sujaygouda123/foc-control/bom/foc-control.csv

Reference | Qty | Value | Exclude from BOM | Footprint | Datasheet | MPN
C1,C2,C3,C4,C6,C7,C8,C9,C10,C12,C16,C40,C47 | 13 | 100 nF 16V X7R |  | Capacitor_SMD:C_0603_1608Metric
C5,C13,C31,C32,C35,C38,C39 | 7 | 1 µF 16V X7R |  | Capacitor_SMD:C_0603_1608Metric
C11 | 1 | 10 µF 16V X5R |  | Capacitor_SMD:C_0603_1608Metric
C14,C15 | 2 | 27 pF 50V C0G |  | Capacitor_SMD:C_0603_1608Metric
C17,C18,C24,C25,C41,C42,C43 | 7 | 2.2 µF 100V X7R |  | Capacitor_SMD:C_1210_3225Metric
C19,C26 | 2 | 2.2 nF 50V X7R |  | Capacitor_SMD:C_0603_1608Metric
C20,C27 | 2 | 3.3 nF 50V X7R |  | Capacitor_SMD:C_0603_1608Metric
C21 | 1 | 56 pF 50V C0G |  | Capacitor_SMD:C_0603_1608Metric
C22,C23 | 2 | 22 µF 25V X7R |  | Capacitor_SMD:C_1210_3225Metric
C28,C30 | 2 | 22 µF 16V X7R |  | Capacitor_SMD:C_1210_3225Metric
C29 | 1 | 180 pF 50V C0G |  | Capacitor_SMD:C_0603_1608Metric
C33 | 1 | 100 nF 25V X7R |  | Capacitor_SMD:C_0603_1608Metric
C34 | 1 | 10 µF 25V X7R |  | Capacitor_SMD:C_1206_3216Metric
C36 | 1 | 47 nF 100V X7R |  | Capacitor_SMD:C_0805_2012Metric
C44,C45 | 2 | 47 µF 100V |  | Capacitor_SMD:CP_Elec_10x10 |  | UUX2A470MNL1GS
C46 | 1 | 10 nF 16V X7R |  | Capacitor_SMD:C_0603_1608Metric
J1 | 1 | BUS_IN |  | XT30:CONN-TH_4P-XT30PW-M |  | XT30PW(2+2)-M.G.B
J2 | 1 | BUS_OUT |  | XT30:CONN-TH_4P-XT30PW-M |  | XT30PW(2+2)-M.G.B
L1,L2 | 2 | 68 µH |  | Inductor_SMD:L_Bourns_SRN6045TA |  | SRN6045TA-680M
Q1,Q2,Q3,Q4,Q5,Q6 | 6 | BSC040N10NS5ATMA1 |  | Package_TO_SOT_SMD:TDSON-8-1 | https://www.infineon.com/dgdl/Infineon-BSC040N10NS5-DS-v02_01-EN.pdf?fileId=5546d4624a0bf290014a0fbcee2e6b38
R1 | 1 | 120 Ω 1% |  | Resistor_SMD:R_0603_1608Metric
R2,R3,R14,R15 | 4 | 10 kΩ |  | Resistor_SMD:R_0603_1608Metric
R4 | 1 | 100k 1% |  | Resistor_SMD:R_0603_1608Metric
R5 | 1 | 453 kΩ 1% |  | Resistor_SMD:R_0603_1608Metric
R6,R11 | 2 | 49.9 kΩ 1% |  | Resistor_SMD:R_0603_1608Metric
R7 | 1 | 453k 1% |  | Resistor_SMD:R_0805_2012Metric
R8 | 1 | 41.2k 1% |  | Resistor_SMD:R_0603_1608Metric
R9 | 1 | 200k 1% |  | Resistor_SMD:R_0805_2012Metric
R10 | 1 | 158k 1% |  | Resistor_SMD:R_0603_1608Metric
R12 | 1 | 1M 1% |  | Resistor_SMD:R_0805_2012Metric
R13 | 1 | 82k 1% |  | Resistor_SMD:R_0603_1608Metric
R16 | 1 | 100k |  | Resistor_SMD:R_0603_1608Metric
R17,R18,R19 | 3 | 1mΩ 1W WSL25121L000FEA |  | Resistor_SMD:R_2512_6332Metric
R20 | 1 | 100k 1% |  | Resistor_SMD:R_1206_3216Metric
R21 | 1 | 3.3k 1% |  | Resistor_SMD:R_0603_1608Metric
R22 | 1 | 10k 1% |  | Resistor_SMD:R_0603_1608Metric
TH1 | 1 | NTC 10k |  | Resistor_SMD:R_0603_1608Metric |  | NCP18XH103F03RB
U1 | 1 | MCP2562FD-E/SN |  | Package_SO:SOIC-8_3.9x4.9mm_P1.27mm | http://ww1.microchip.com/downloads/en/DeviceDoc/25167A.pdf
U2 | 1 | AS5047P-ATSM |  | Package_SO:TSSOP-14_4.4x5mm_P0.65mm | https://www.infineon.com/assets/row/public/documents/30/49/infineon-as5047p-datasheet-en.pdf
U3 | 1 | STM32G474RET3 |  | Package_QFP:LQFP-64_10x10mm_P0.5mm | https://www.st.com/resource/en/datasheet/stm32g474re.pdf
U4,U5 | 2 | LM5164DDAR |  | Package_SO:HSOP-8-1EP_3.9x4.9mm_P1.27mm_EP2.41x3.1mm_ThermalVias | https://www.ti.com/lit/ds/symlink/lm5164.pdf
U6 | 1 | AP2112K-3.3 |  | Package_TO_SOT_SMD:SOT-23-5 | https://www.diodes.com/assets/Datasheets/AP2112.pdf
U7 | 1 | DRV8353SRTAR |  | DRV8353:RTA0040B | https://www.ti.com/lit/ds/symlink/drv8353.pdf
Y1 | 1 | ABM3B-8.000MHZ-B2-T |  | Crystal:Crystal_SMD_Abracon_ABM3B-4Pin_5.0x3.2mm | https://abracon.com/Resonators/abm3b.pdf
