sujaygouda123/foc-control/foc-control.kicad_pcb

## KiCad design foc-control.kicad_pcb (2026-10-22)

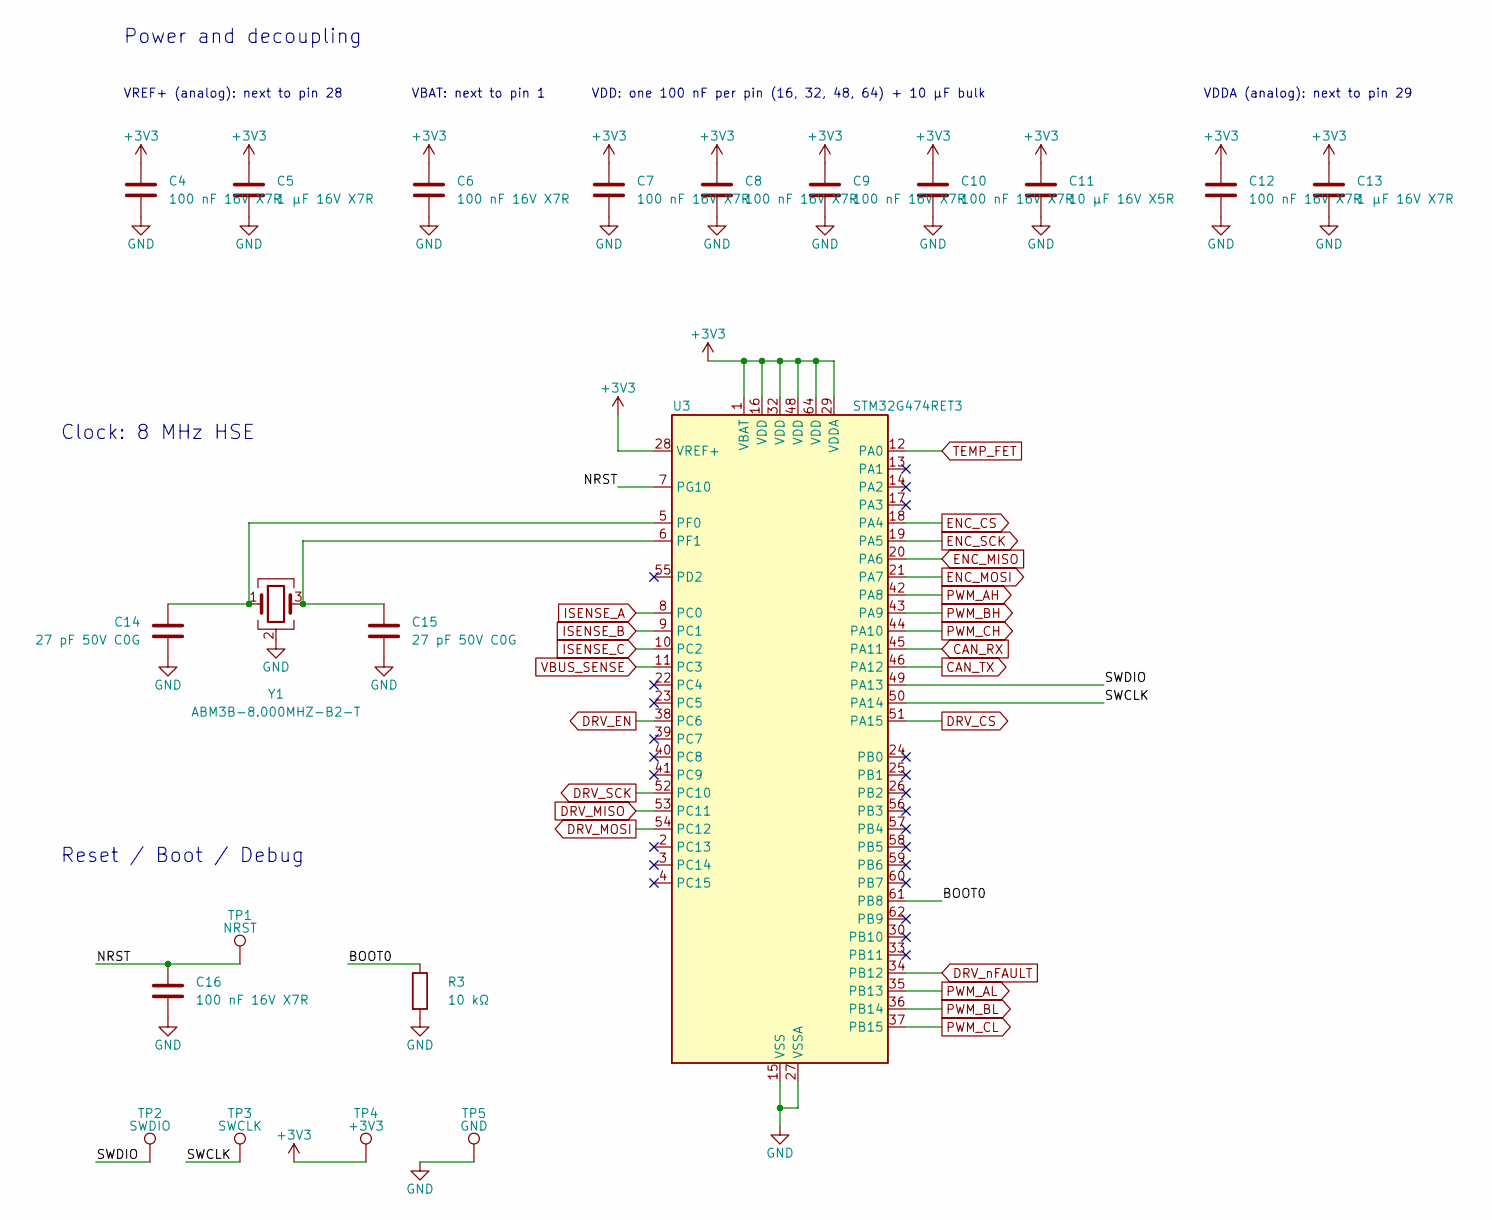
[picture p5: schematic MCU.kicad_sch]

Parts:
C4, C6, C7, C8, C9, C10, C12, C16: 100 nF 16V X7R; C_0603_1608Metric
C5, C13: 1 µF 16V X7R; C_0603_1608Metric
C11: 10 µF 16V X5R; C_0603_1608Metric
C14, C15: 27 pF 50V C0G; C_0603_1608Metric
R3: 10 kΩ; R_0603_1608Metric
TP1: NRST; TestPoint_Pad_D1.0mm
TP2: SWDIO; TestPoint_Pad_D1.0mm
TP3: SWCLK; TestPoint_Pad_D1.0mm
TP4: +3V3; TestPoint_Pad_D1.0mm
TP5: GND; TestPoint_Pad_D1.0mm
U3: STM32G474RET3; LQFP-64_10x10mm_P0.5mm
Y1: ABM3B-8.000MHZ-B2-T; Crystal_SMD_Abracon_ABM3B-4Pin_5.0x3.2mm

Connections:
+3V3: C4.1, C5.1, C6.1, C7.1, C8.1, C9.1, C10.1, C11.1, C12.1, C13.1, TP4.1 (1_1), U3.1 (VBAT), U3.16 (VDD), U3.28 (VREF+), U3.29 (VDDA), U3.32 (VDD), U3.48 (VDD), U3.64 (VDD); also elsewhere on the board
/MCU/BOOT0: R3.1, U3.61 (PB8)
/MCU/NRST: C16.1, TP1.1 (1_1), U3.7 (PG10)
/MCU/SWCLK: TP3.1 (1_1), U3.50 (PA14)
/MCU/SWDIO: TP2.1 (1_1), U3.49 (PA13)
CAN_RX: U3.45 (PA11); also elsewhere on the board
CAN_TX: U3.46 (PA12); also elsewhere on the board
DRV_CS: U3.51 (PA15); also elsewhere on the board
DRV_EN: U3.38 (PC6); also elsewhere on the board
DRV_MISO: U3.53 (PC11); also elsewhere on the board
DRV_MOSI: U3.54 (PC12); also elsewhere on the board
DRV_SCK: U3.52 (PC10); also elsewhere on the board
DRV_nFAULT: U3.34 (PB12); also elsewhere on the board
ENC_CS: U3.18 (PA4); also elsewhere on the board
ENC_MISO: U3.20 (PA6); also elsewhere on the board
ENC_MOSI: U3.21 (PA7); also elsewhere on the board
ENC_SCK: U3.19 (PA5); also elsewhere on the board
GND: C4.2, C5.2, C6.2, C7.2, C8.2, C9.2, C10.2, C11.2, C12.2, C13.2, C14.2, C15.2, C16.2, R3.2, TP5.1 (1_1), U3.15 (VSS), U3.27 (VSSA), U3.31 (VSS), U3.47 (VSS), U3.63 (VSS), Y1.2 (G), Y1.4 (G); also elsewhere on the board
ISENSE_A: U3.8 (PC0); also elsewhere on the board
ISENSE_B: U3.9 (PC1); also elsewhere on the board
ISENSE_C: U3.10 (PC2); also elsewhere on the board
unnamed: C14.1, U3.5 (PF0), Y1.1
unnamed: C15.1, U3.6 (PF1), Y1.3
PWM_AH: U3.42 (PA8); also elsewhere on the board
PWM_AL: U3.35 (PB13); also elsewhere on the board
PWM_BH: U3.43 (PA9); also elsewhere on the board
PWM_BL: U3.36 (PB14); also elsewhere on the board
PWM_CH: U3.44 (PA10); also elsewhere on the board
PWM_CL: U3.37 (PB15); also elsewhere on the board
TEMP_FET: U3.12 (PA0); also elsewhere on the board
VBUS_SENSE: U3.11 (PC3); also elsewhere on the board

Notes on the sheet:
Power and decoupling
Clock: 8 MHz HSE
VDDA (analog): next to pin 29
VREF+ (analog): next to pin 28
VBAT: next to pin 1
Reset / Boot / Debug
VDD: one 100 nF per pin (16, 32, 48, 64) + 10 µF bulk

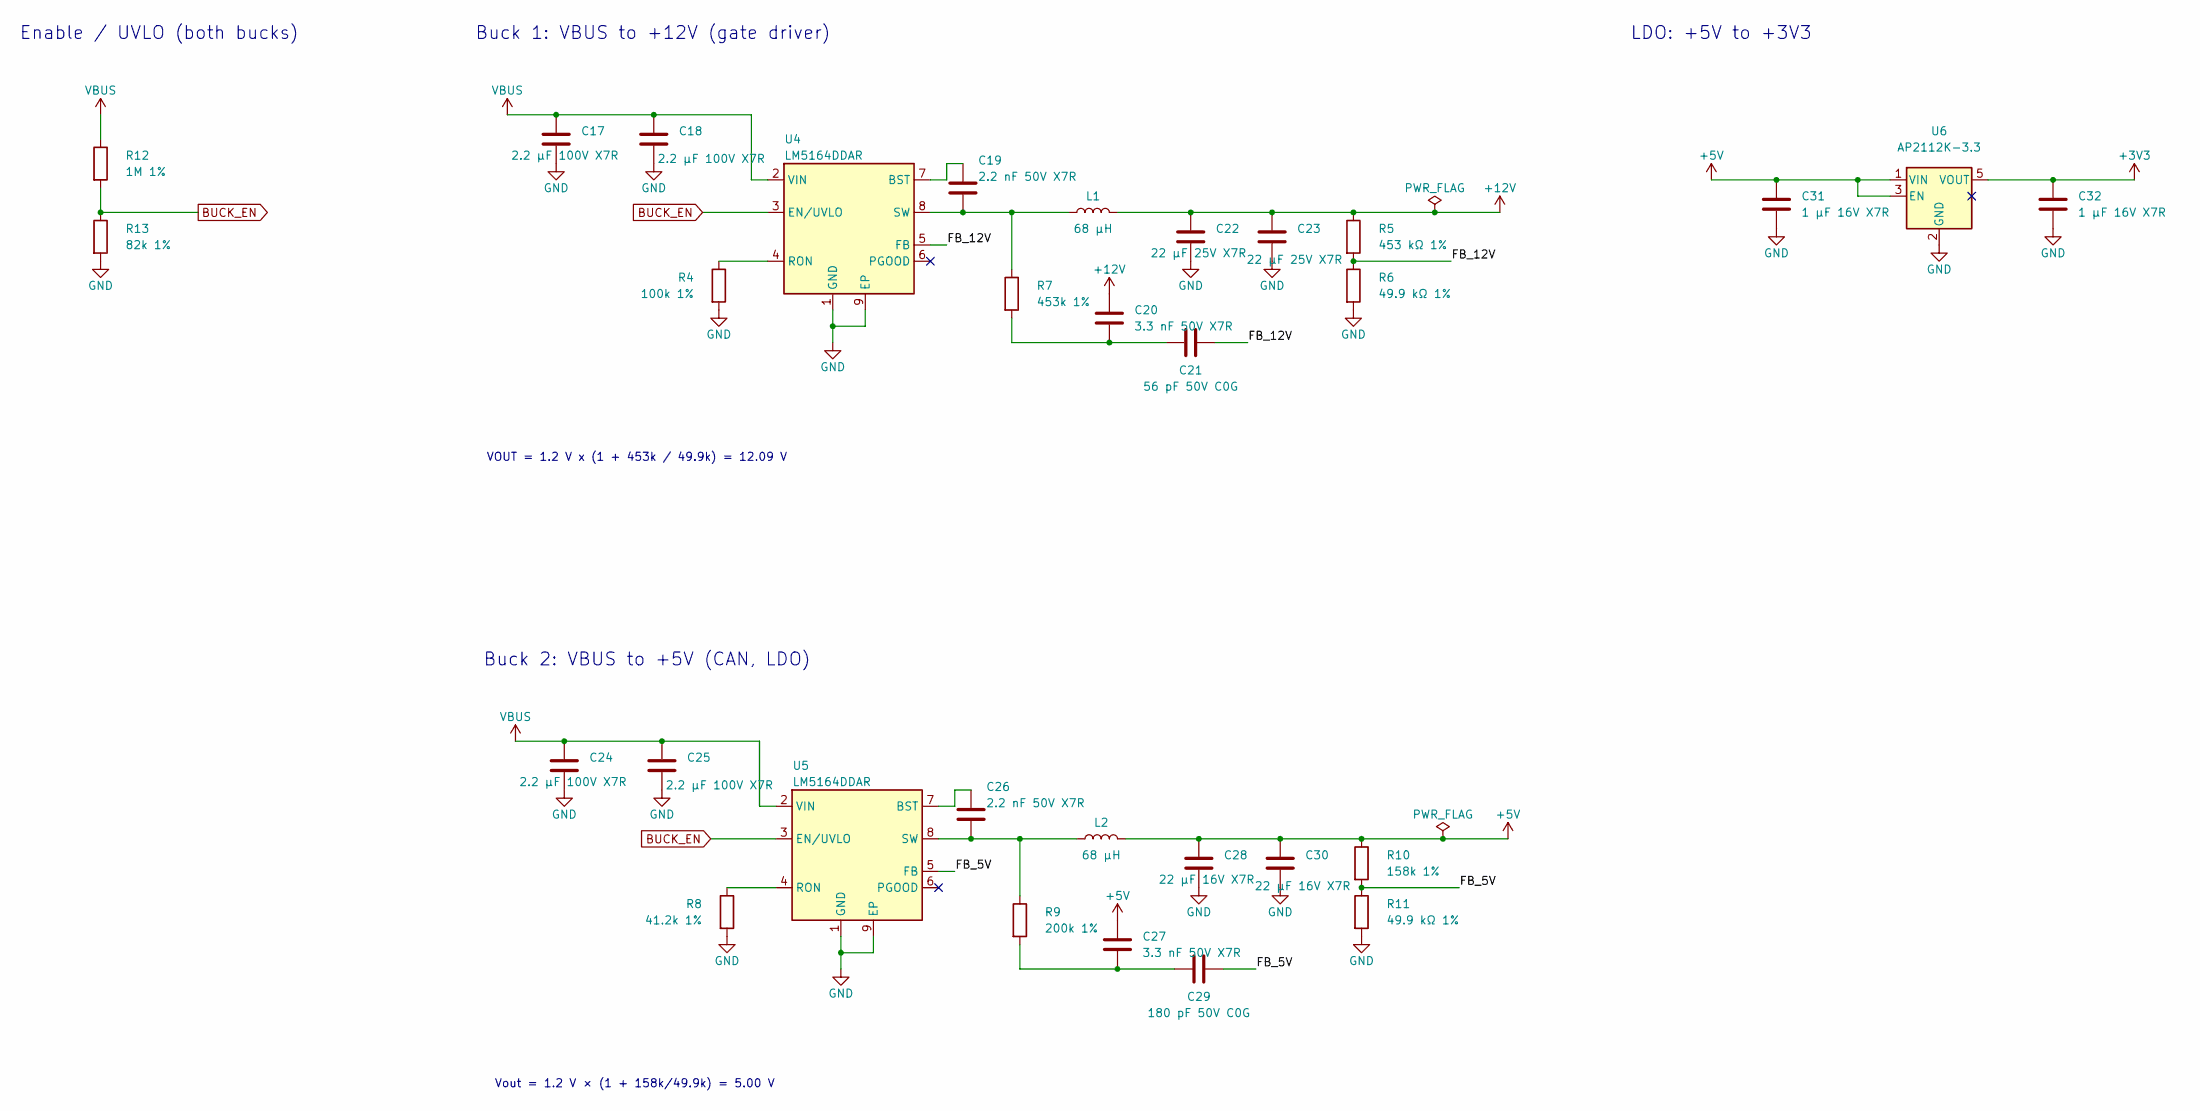
[picture p6: schematic power_rails.kicad_sch, Power Rails]

Parts:
C17, C18, C24, C25: 2.2 µF 100V X7R; C_1210_3225Metric
C19, C26: 2.2 nF 50V X7R; C_0603_1608Metric
C20, C27: 3.3 nF 50V X7R; C_0603_1608Metric
C21: 56 pF 50V C0G; C_0603_1608Metric
C22, C23: 22 µF 25V X7R; C_1210_3225Metric
C28, C30: 22 µF 16V X7R; C_1210_3225Metric
C29: 180 pF 50V C0G; C_0603_1608Metric
C31, C32: 1 µF 16V X7R; C_0603_1608Metric
L1, L2: 68 µH; L_Bourns_SRN6045TA; MPN SRN6045TA-680M
R4: 100k 1%; R_0603_1608Metric
R5: 453 kΩ 1%; R_0603_1608Metric
R6, R11: 49.9 kΩ 1%; R_0603_1608Metric
R7: 453k 1%; R_0805_2012Metric
R8: 41.2k 1%; R_0603_1608Metric
R9: 200k 1%; R_0805_2012Metric
R10: 158k 1%; R_0603_1608Metric
R12: 1M 1%; R_0805_2012Metric
R13: 82k 1%; R_0603_1608Metric
U4, U5: LM5164DDAR; HSOP-8-1EP_3.9x4.9mm_P1.27mm_EP2.41x3.1mm_ThermalVias
U6: AP2112K-3.3; SOT-23-5

Connections:
+3V3: C32.1, U6.5 (VOUT); also elsewhere on the board
+5V: C27.1, C28.1, C30.1, C31.1, L2.2, R10.1, U6.1 (VIN), U6.3 (EN); also elsewhere on the board
+12V: C20.1, C22.1, C23.1, L1.2, R5.1; also elsewhere on the board
/Power Rails/FB_5V: C29.2, R10.2, R11.1, U5.5 (FB)
/Power Rails/FB_12V: C21.2, R5.2, R6.1, U4.5 (FB)
BUCK_EN: R12.2, R13.1, U4.3 (EN/UVLO), U5.3 (EN/UVLO)
GND: C17.2, C18.2, C22.2, C23.2, C24.2, C25.2, C28.2, C30.2, C31.2, C32.2, R4.2, R6.2, R8.2, R11.2, R13.2, U4.1 (GND), U4.9 (EP), U5.1 (GND), U5.9 (EP), U6.2 (GND); also elsewhere on the board
unnamed: C20.2, C21.1, R7.2
unnamed: C27.2, C29.1, R9.2
unnamed: C19.1, U4.7 (BST)
unnamed: R4.1, U4.4 (RON)
unnamed: C19.2, L1.1, R7.1, U4.8 (SW)
unnamed: C26.1, U5.7 (BST)
unnamed: R8.1, U5.4 (RON)
unnamed: C26.2, L2.1, R9.1, U5.8 (SW)
VBUS: C17.1, C18.1, C24.1, C25.1, R12.1, U4.2 (VIN), U5.2 (VIN); also elsewhere on the board

Notes on the sheet:
Buck 1: VBUS to +12V (gate driver)
LDO: +5V to +3V3
Enable / UVLO (both bucks)
VOUT = 1.2 V x (1 + 453k / 49.9k) = 12.09 V
Buck 2: VBUS to +5V (CAN, LDO)
Vout = 1.2 V × (1 + 158k/49.9k) = 5.00 V

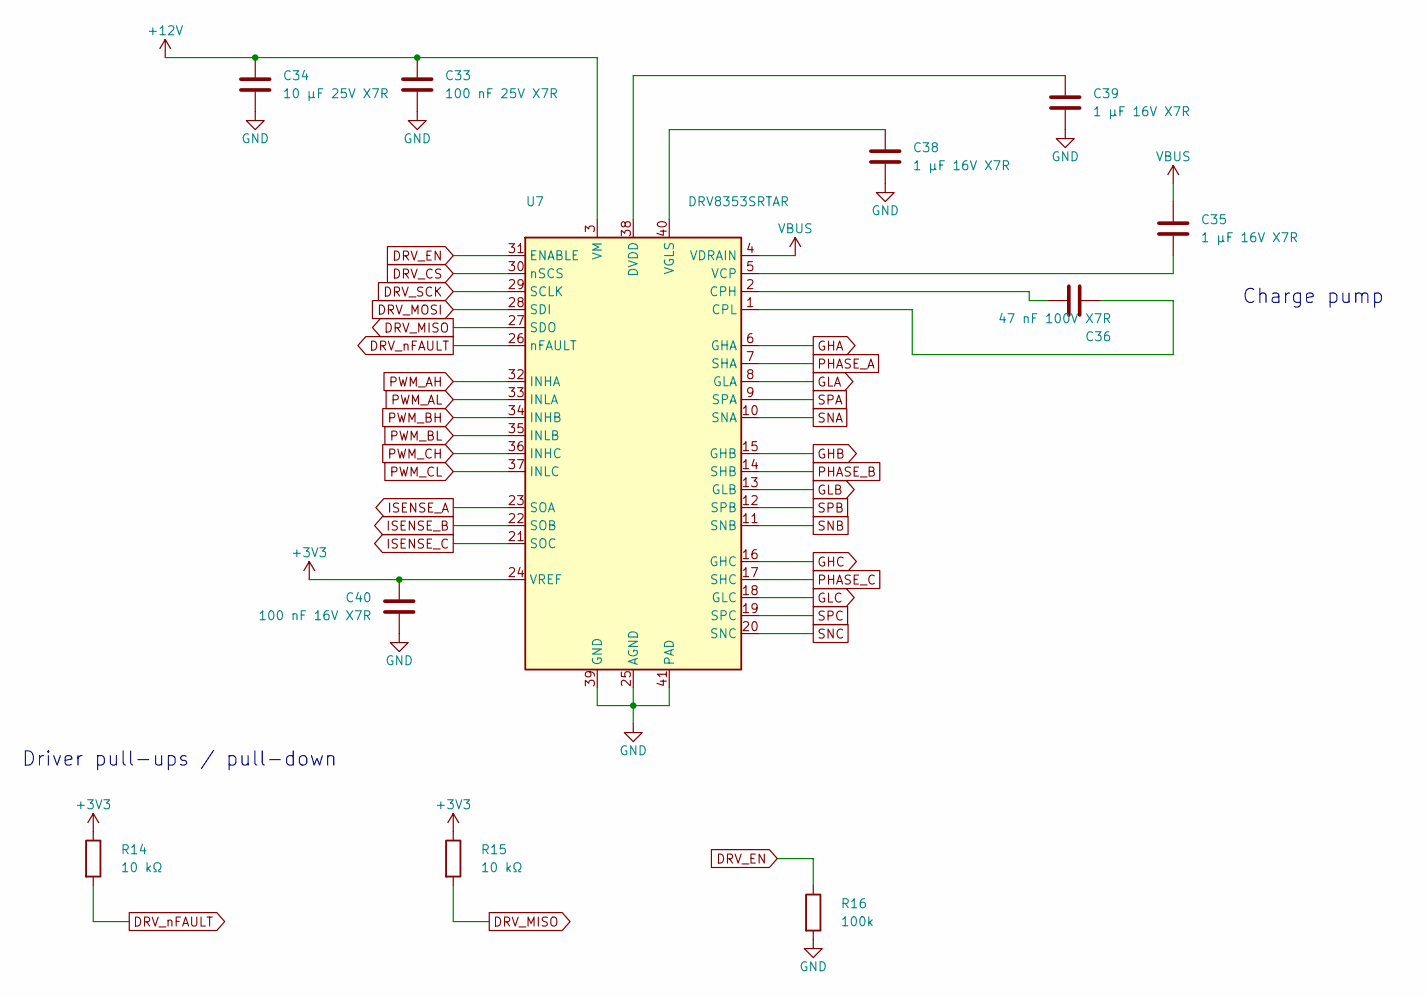
[picture p7: schematic gate_driver.kicad_sch, Gate Driver]

Parts:
C33: 100 nF 25V X7R; C_0603_1608Metric
C34: 10 µF 25V X7R; C_1206_3216Metric
C35, C38, C39: 1 µF 16V X7R; C_0603_1608Metric
C36: 47 nF 100V X7R; C_0805_2012Metric
C40: 100 nF 16V X7R; C_0603_1608Metric
R14, R15: 10 kΩ; R_0603_1608Metric
R16: 100k; R_0603_1608Metric
U7: DRV8353SRTAR; RTA0040B

Connections:
+3V3: C40.1, R14.1, R15.1, U7.24 (VREF); also elsewhere on the board
+12V: C33.1, C34.1, U7.3 (VM); also elsewhere on the board
DRV_CS: U7.30 (nSCS); also elsewhere on the board
DRV_EN: R16.1, U7.31 (ENABLE); also elsewhere on the board
DRV_MISO: R15.2, U7.27 (SDO); also elsewhere on the board
DRV_MOSI: U7.28 (SDI); also elsewhere on the board
DRV_SCK: U7.29 (SCLK); also elsewhere on the board
DRV_nFAULT: R14.2, U7.26 (nFAULT); also elsewhere on the board
GHA: U7.6 (GHA); also elsewhere on the board
GHB: U7.15 (GHB); also elsewhere on the board
GHC: U7.16 (GHC); also elsewhere on the board
GLA: U7.8 (GLA); also elsewhere on the board
GLB: U7.13 (GLB); also elsewhere on the board
GLC: U7.18 (GLC); also elsewhere on the board
GND: C33.2, C34.2, C38.2, C39.2, C40.2, R16.2, U7.25 (AGND), U7.39 (GND), U7.41 (PAD); also elsewhere on the board
ISENSE_A: U7.23 (SOA); also elsewhere on the board
ISENSE_B: U7.22 (SOB); also elsewhere on the board
ISENSE_C: U7.21 (SOC); also elsewhere on the board
unnamed: C36.1, U7.2 (CPH)
unnamed: C36.2, U7.1 (CPL)
unnamed: C39.1, U7.38 (DVDD)
unnamed: C35.2, U7.5 (VCP)
unnamed: C38.1, U7.40 (VGLS)
PHASE_A: U7.7 (SHA); also elsewhere on the board
PHASE_B: U7.14 (SHB); also elsewhere on the board
PHASE_C: U7.17 (SHC); also elsewhere on the board
PWM_AH: U7.32 (INHA); also elsewhere on the board
PWM_AL: U7.33 (INLA); also elsewhere on the board
PWM_BH: U7.34 (INHB); also elsewhere on the board
PWM_BL: U7.35 (INLB); also elsewhere on the board
PWM_CH: U7.36 (INHC); also elsewhere on the board
PWM_CL: U7.37 (INLC); also elsewhere on the board
SNA: U7.10 (SNA); also elsewhere on the board
SNB: U7.11 (SNB); also elsewhere on the board
SNC: U7.20 (SNC); also elsewhere on the board
SPA: U7.9 (SPA); also elsewhere on the board
SPB: U7.12 (SPB); also elsewhere on the board
SPC: U7.19 (SPC); also elsewhere on the board
VBUS: C35.1, U7.4 (VDRAIN); also elsewhere on the board

Notes on the sheet:
Driver pull-ups / pull-down
Charge pump

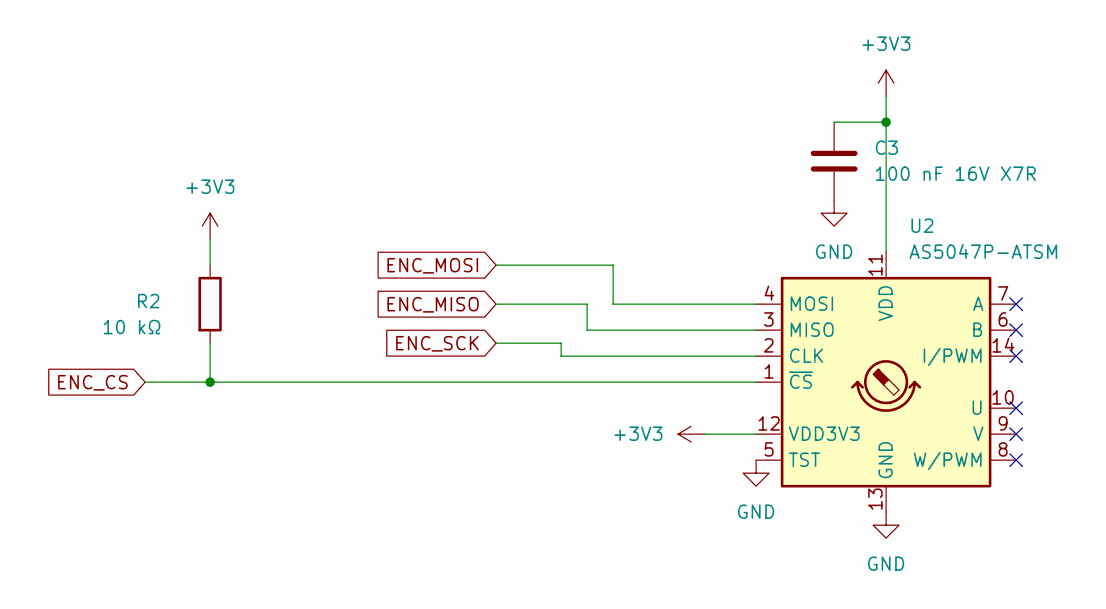
[picture p8: schematic encoder.kicad_sch]

Parts:
C3: 100 nF 16V X7R; C_0603_1608Metric
R2: 10 kΩ; R_0603_1608Metric
U2: AS5047P-ATSM; TSSOP-14_4.4x5mm_P0.65mm

Connections:
+3V3: C3.1, R2.1, U2.11 (VDD), U2.12 (VDD3V3); also elsewhere on the board
ENC_CS: R2.2, U2.1 (~CS); also elsewhere on the board
ENC_MISO: U2.3 (MISO); also elsewhere on the board
ENC_MOSI: U2.4 (MOSI); also elsewhere on the board
ENC_SCK: U2.2 (CLK); also elsewhere on the board
GND: C3.2, U2.5 (TST), U2.13 (GND); also elsewhere on the board

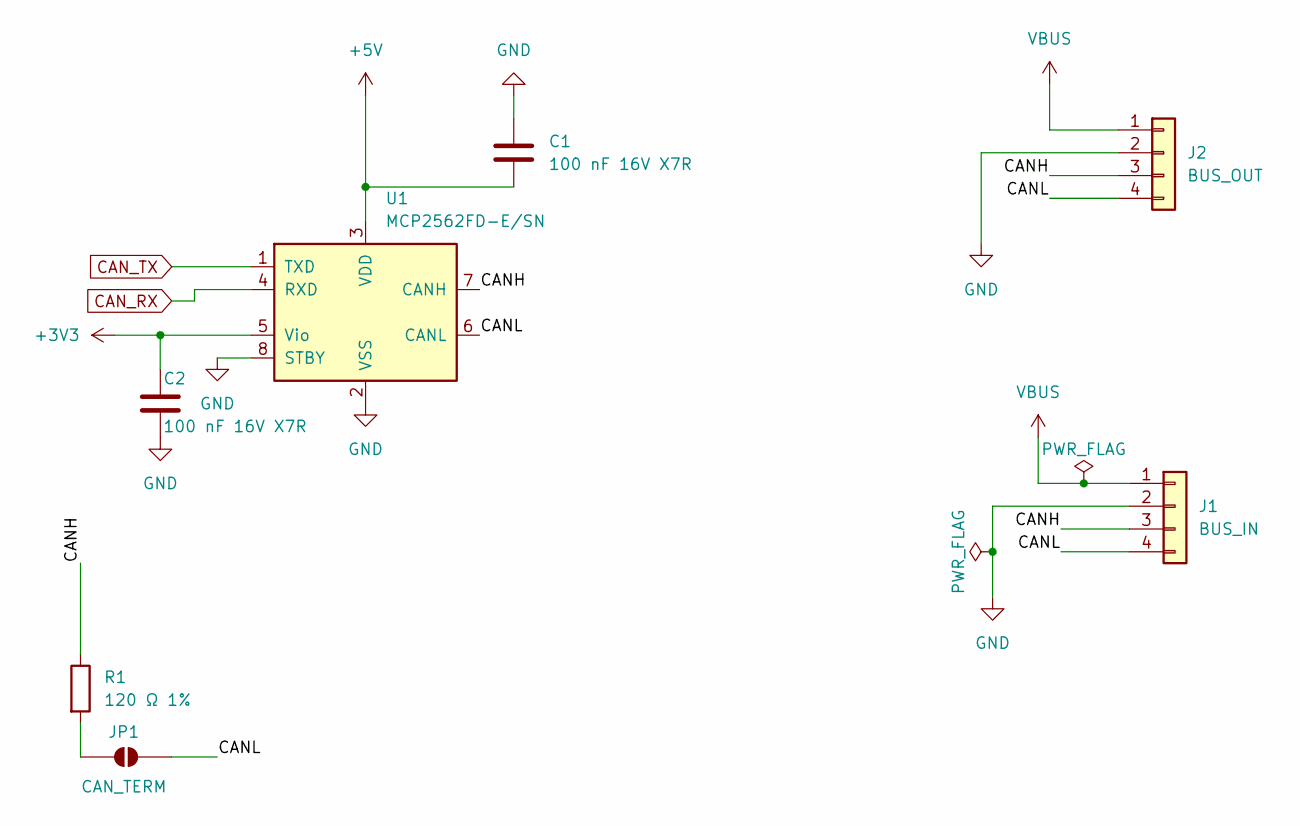
[picture p9: schematic can_connectors.kicad_sch]

Parts:
C1, C2: 100 nF 16V X7R; C_0603_1608Metric
J1: BUS_IN; CONN-TH_4P-XT30PW-M; MPN XT30PW(2+2)-M.G.B
J2: BUS_OUT; CONN-TH_4P-XT30PW-M; MPN XT30PW(2+2)-M.G.B
JP1: CAN_TERM; SolderJumper-2_P1.3mm_Open_RoundedPad1.0x1.5mm
R1: 120 Ω 1%; R_0603_1608Metric
U1: MCP2562FD-E/SN; SOIC-8_3.9x4.9mm_P1.27mm

Connections:
+3V3: C2.1, U1.5 (Vio); also elsewhere on the board
+5V: C1.2, U1.3 (VDD); also elsewhere on the board
/CAN + Connectors/CANH: J1.3, J2.3, R1.1, U1.7 (CANH)
/CAN + Connectors/CANL: J1.4, J2.4, JP1.2 (B), U1.6 (CANL)
CAN_RX: U1.4 (RXD); also elsewhere on the board
CAN_TX: U1.1 (TXD); also elsewhere on the board
GND: C1.1, C2.2, J1.2, J2.2, U1.2 (VSS), U1.8 (STBY); also elsewhere on the board
unnamed: JP1.1 (A), R1.2
VBUS: J1.1, J2.1; also elsewhere on the board

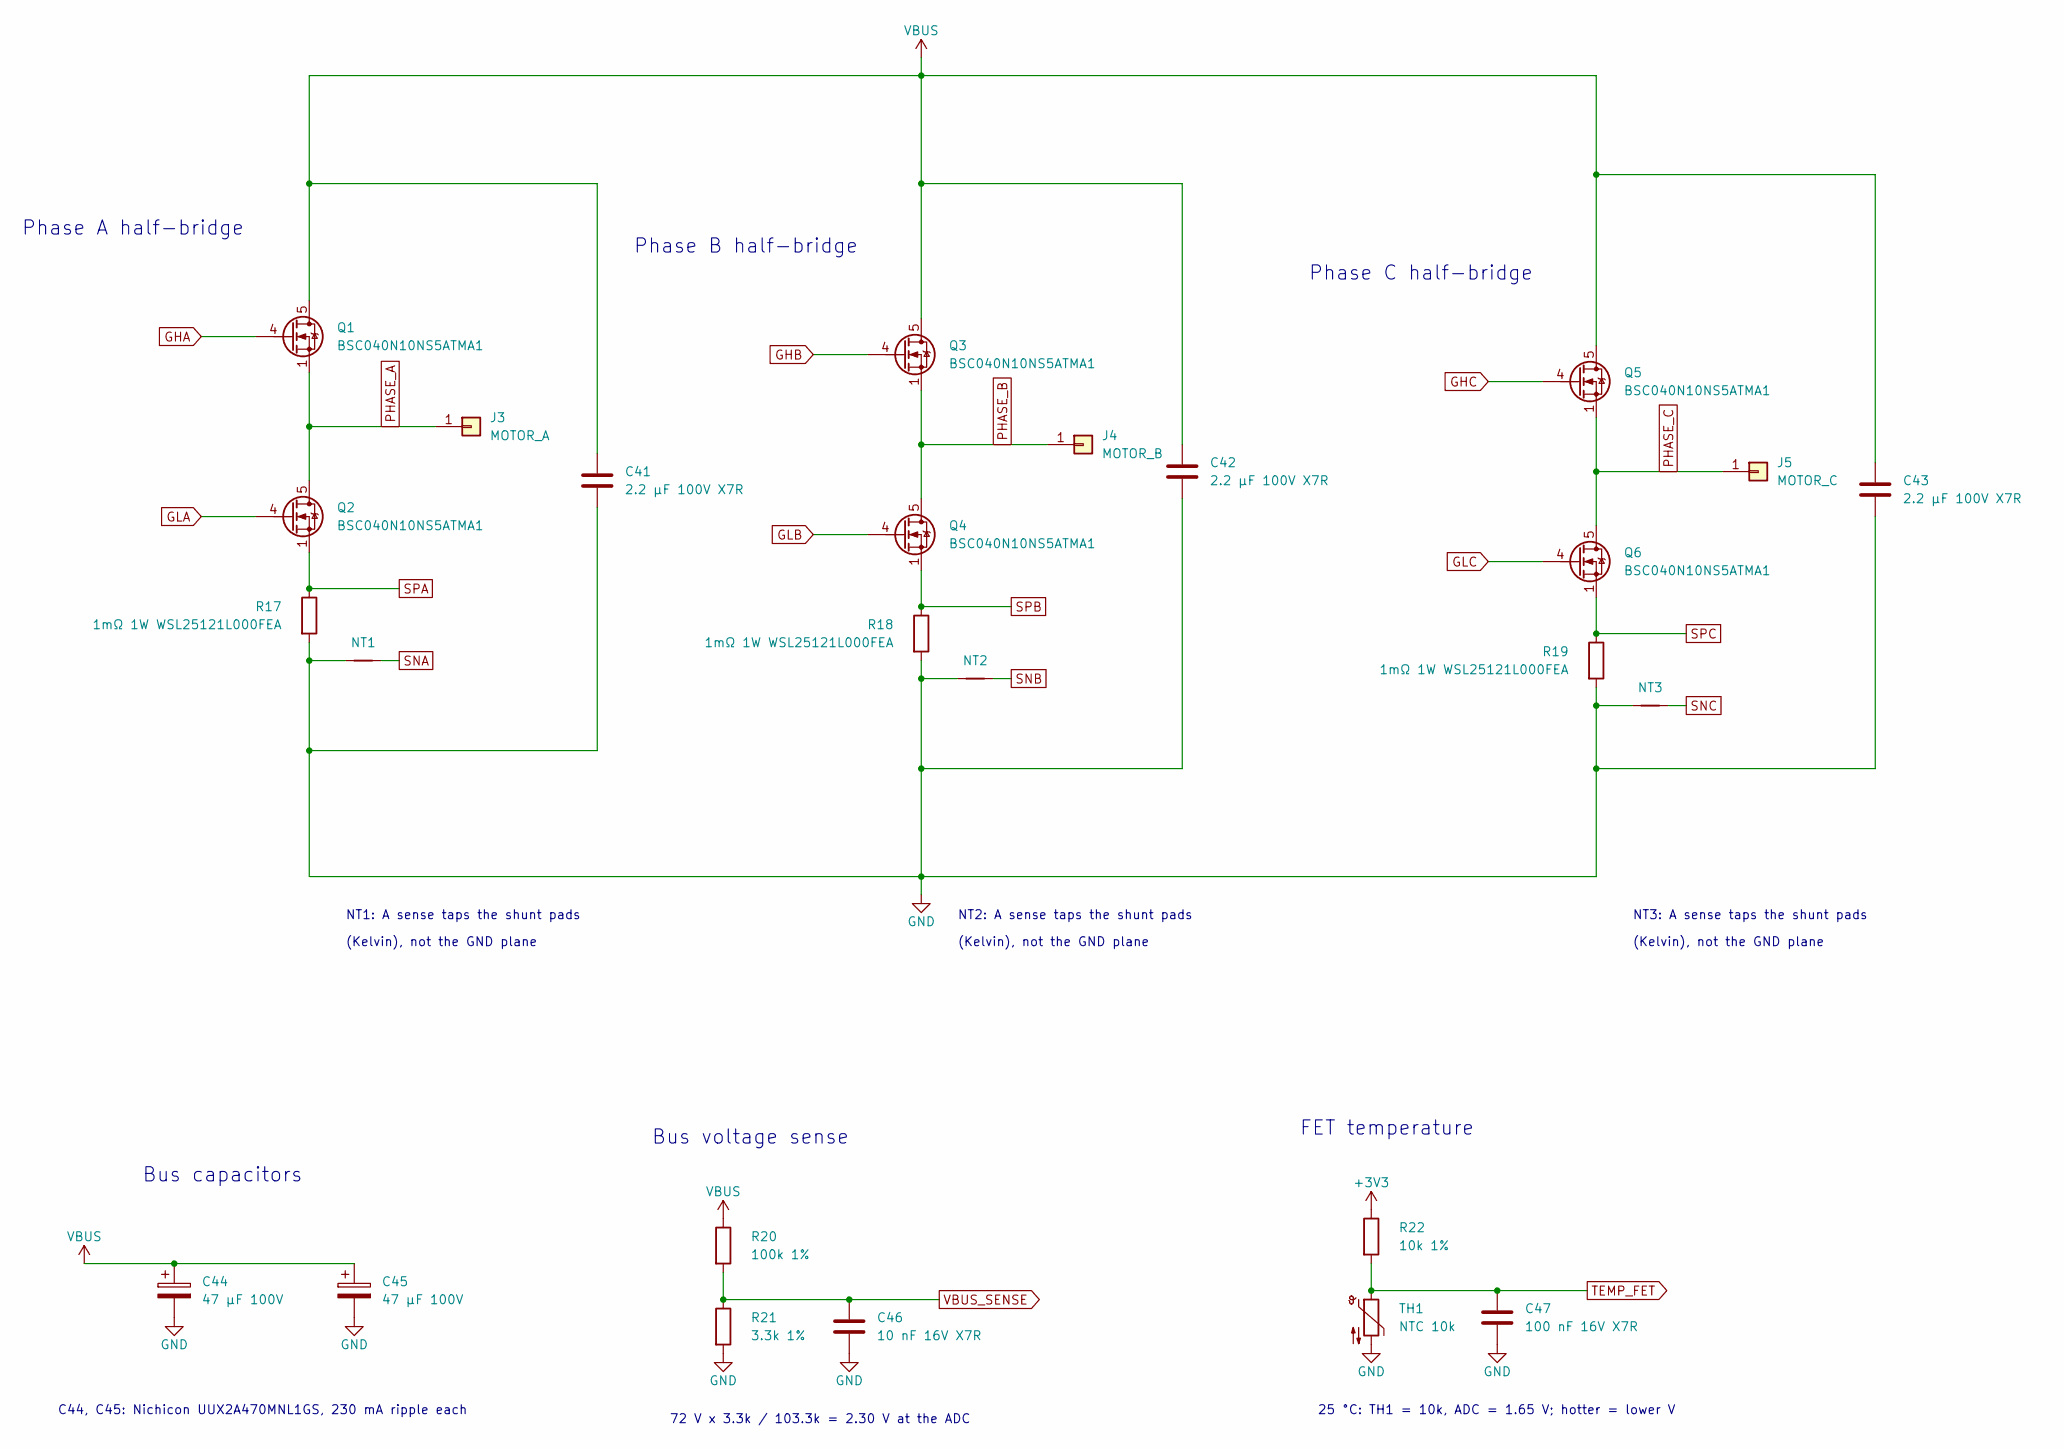
[picture p10: schematic power_stage.kicad_sch, Power Stage]

Parts:
C41, C42, C43: 2.2 µF 100V X7R; C_1210_3225Metric
C44, C45: 47 µF 100V; CP_Elec_10x10; MPN UUX2A470MNL1GS
C46: 10 nF 16V X7R; C_0603_1608Metric
C47: 100 nF 16V X7R; C_0603_1608Metric
J3: MOTOR_A; SolderWire-1.5sqmm_1x01_D1.7mm_OD3.9mm
J4: MOTOR_B; SolderWire-1.5sqmm_1x01_D1.7mm_OD3.9mm
J5: MOTOR_C; SolderWire-1.5sqmm_1x01_D1.7mm_OD3.9mm
NT1, NT2, NT3: NetTie_2; NetTie-2_SMD_Pad0.5mm
Q1, Q2, Q3, Q4, Q5, Q6: BSC040N10NS5ATMA1; TDSON-8-1
R17, R18, R19: 1mΩ 1W WSL25121L000FEA; R_2512_6332Metric
R20: 100k 1%; R_1206_3216Metric
R21: 3.3k 1%; R_0603_1608Metric
R22: 10k 1%; R_0603_1608Metric
TH1: NTC 10k; R_0603_1608Metric; MPN NCP18XH103F03RB

Connections:
+3V3: R22.1; also elsewhere on the board
GHA: Q1.4 (G); also elsewhere on the board
GHB: Q3.4 (G); also elsewhere on the board
GHC: Q5.4 (G); also elsewhere on the board
GLA: Q2.4 (G); also elsewhere on the board
GLB: Q4.4 (G); also elsewhere on the board
GLC: Q6.4 (G); also elsewhere on the board
GND: C41.2, C42.2, C43.2, C44.2, C45.2, C46.2, C47.2, NT1.1, NT2.1, NT3.1, R17.2, R18.2, R19.2, R21.2, TH1.2; also elsewhere on the board
PHASE_A: J3.1 (Pin_1_1), Q1.1 (S), Q1.2 (S), Q1.3 (S), Q2.5 (D); also elsewhere on the board
PHASE_B: J4.1 (Pin_1_1), Q3.1 (S), Q3.2 (S), Q3.3 (S), Q4.5 (D); also elsewhere on the board
PHASE_C: J5.1 (Pin_1_1), Q5.1 (S), Q5.2 (S), Q5.3 (S), Q6.5 (D); also elsewhere on the board
SNA: NT1.2; also elsewhere on the board
SNB: NT2.2; also elsewhere on the board
SNC: NT3.2; also elsewhere on the board
SPA: Q2.1 (S), Q2.2 (S), Q2.3 (S), R17.1; also elsewhere on the board
SPB: Q4.1 (S), Q4.2 (S), Q4.3 (S), R18.1; also elsewhere on the board
SPC: Q6.1 (S), Q6.2 (S), Q6.3 (S), R19.1; also elsewhere on the board
TEMP_FET: C47.1, R22.2, TH1.1; also elsewhere on the board
VBUS: C41.1, C42.1, C43.1, C44.1, C45.1, Q1.5 (D), Q3.5 (D), Q5.5 (D), R20.1; also elsewhere on the board
VBUS_SENSE: C46.1, R20.2, R21.1; also elsewhere on the board

Notes on the sheet:
(Kelvin), not the GND plane
72 V x 3.3k / 103.3k = 2.30 V at the ADC
Bus capacitors
NT3: A sense taps the shunt pads
Phase B half-bridge
Phase A half-bridge
25 °C: TH1 = 10k, ADC = 1.65 V; hotter = lower V
Bus voltage sense
NT2: A sense taps the shunt pads
Phase C half-bridge
C44, C45: Nichicon UUX2A470MNL1GS, 230 mA ripple each
NT1: A sense taps the shunt pads
FET temperature

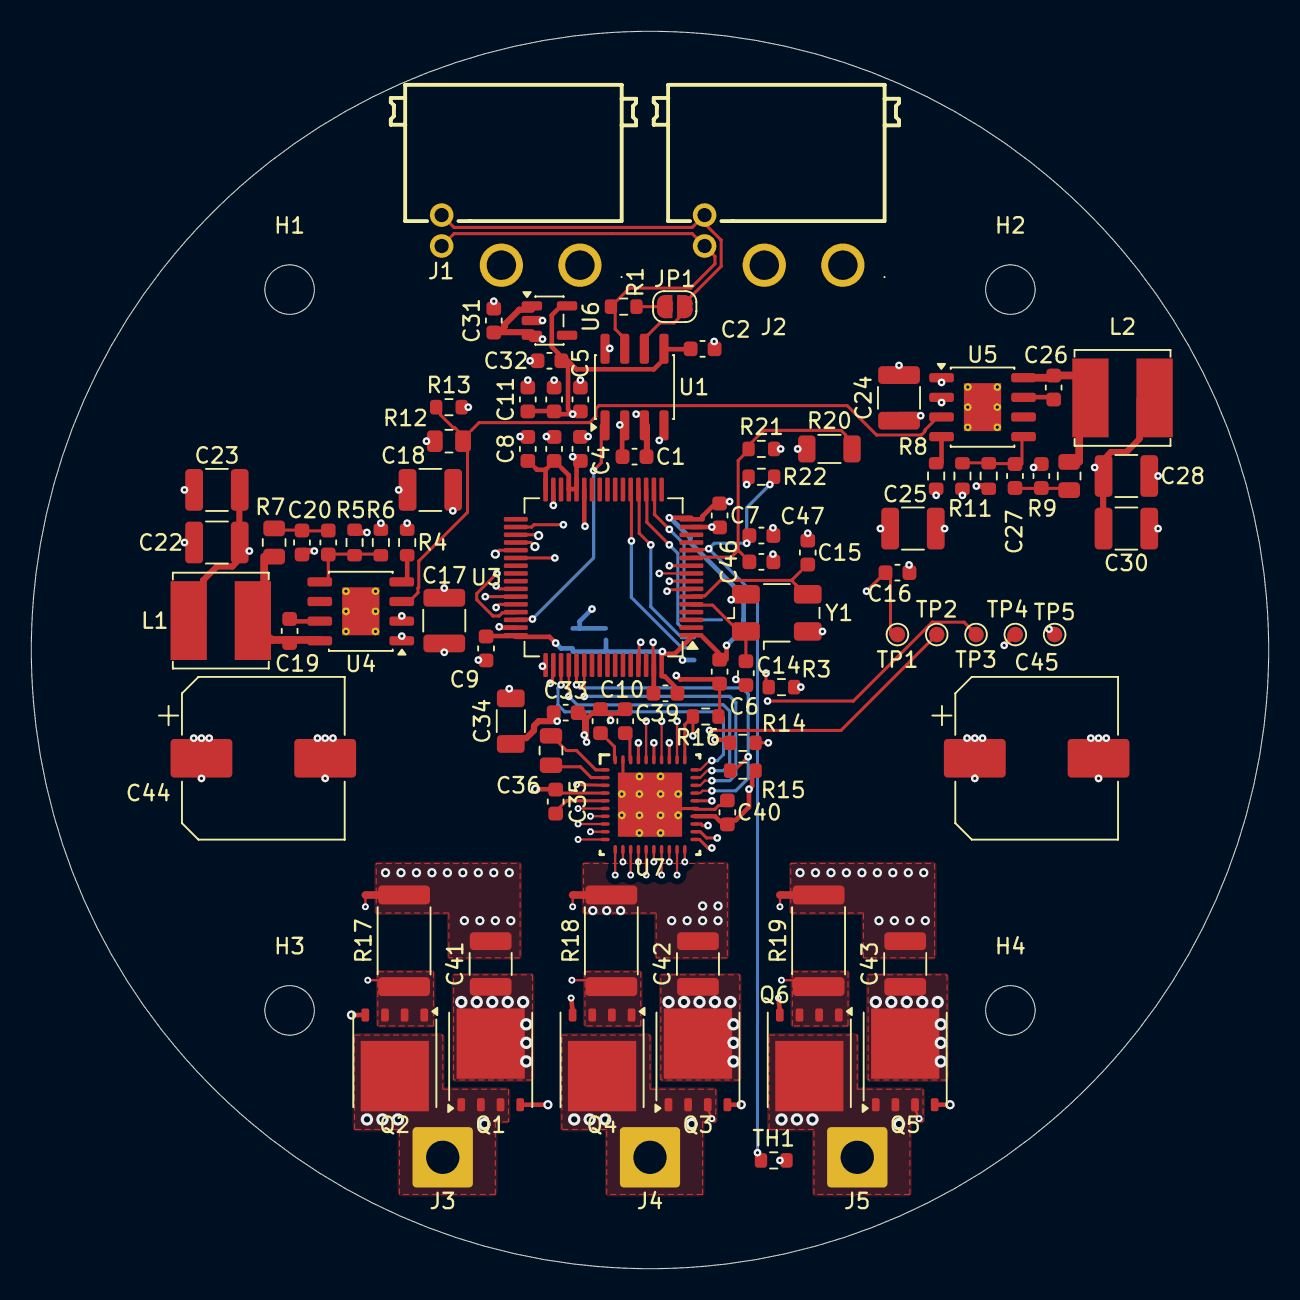
[picture p11: board foc-control.kicad_pcb from above]

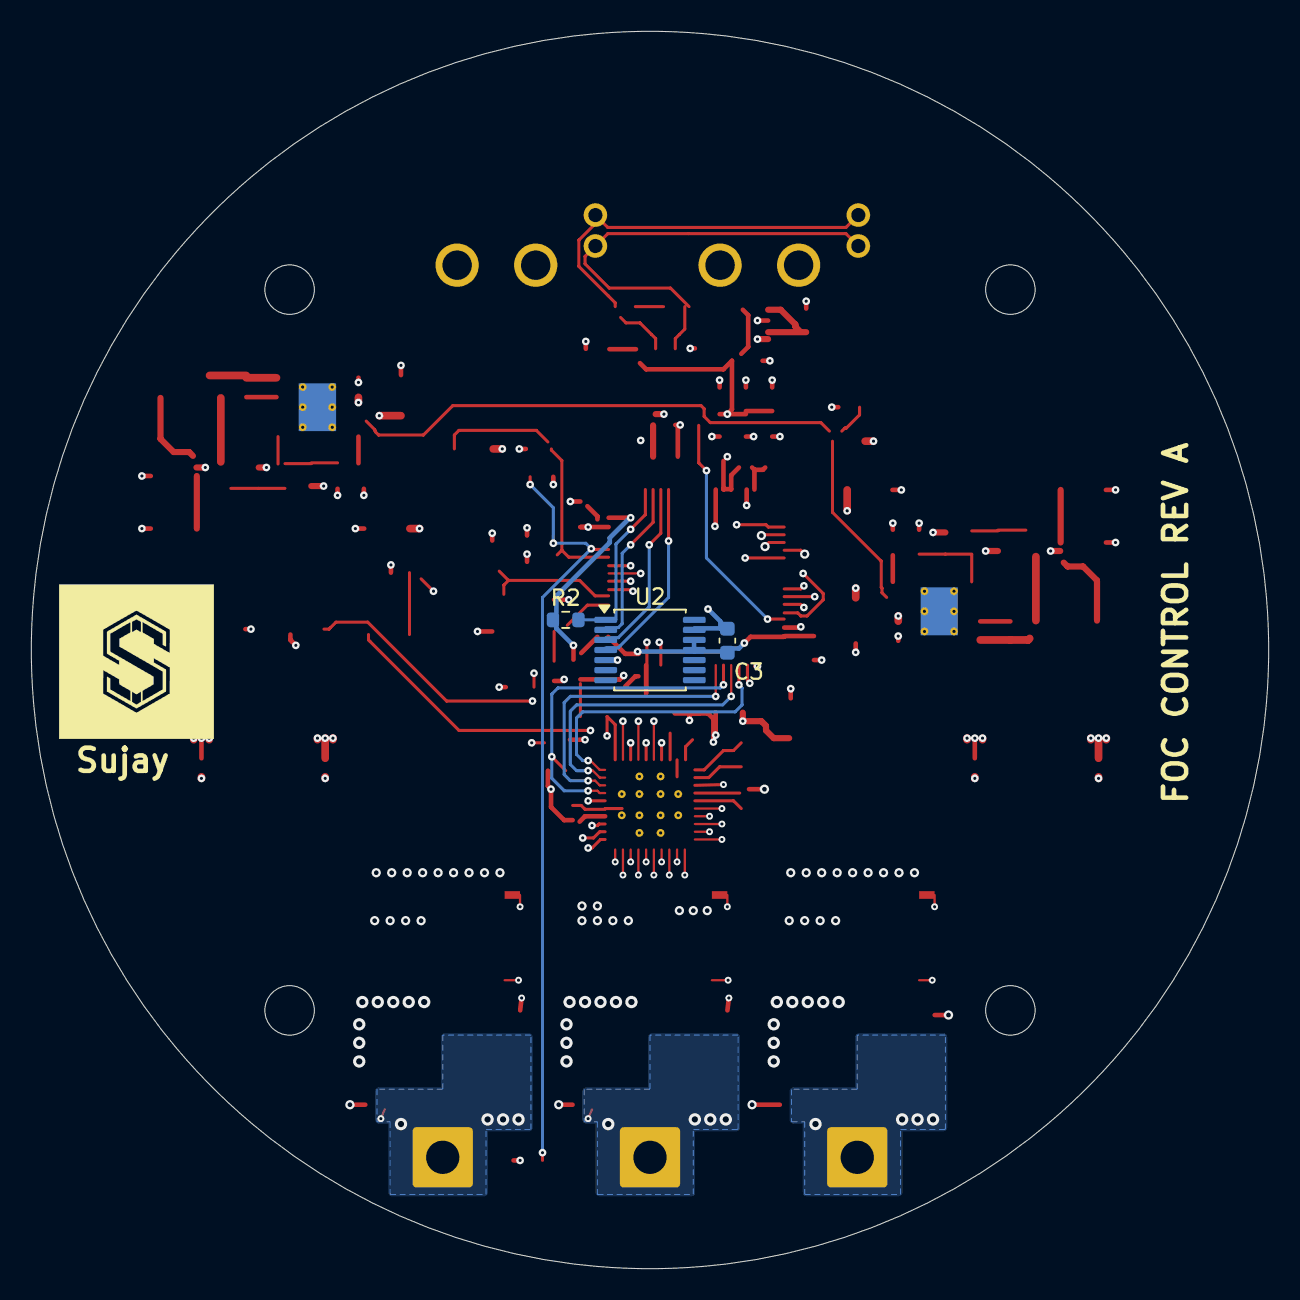
[picture p12: board foc-control.kicad_pcb from below]

Board: 8 copper layers, 80.0 x 80.0 mm, 103 parts (3 on the bottom side), 68 nets.

Other parts of the board:
H1, H2, H3, H4: MountingHole_3.2mm_M3
