sujaygouda123/foc-control/(commit log)

2026-10-22 FOC controller Rev A KiCad project
    [MCU.kicad_sch, can_connectors.kicad_sch, encoder.kicad_sch, foc-control.csv, foc-control.kicad_pcb, foc-control.kicad_sch, gate_driver.kicad_sch, power_rails.kicad_sch]
2026-10-23 Rev A: silkscreen 0.15 mm, README updates
    [foc-control.kicad_pcb]
2026-10-23 Revert "Rev A: silkscreen 0.15 mm, README updates"
    This reverts commit 30a5c7fdb7eb92f7d814f686d8414c1fff57f6f5.
    [foc-control.kicad_pcb]
